j1sebasM9/Dise-o-proyecto-CubeSat-UD34-2026-2/altium/Analisis_BOM_exhaustivo.xlsx

Sheet: Resumen
Numeral 11 – Costo de componentes de la tarjeta CubeSat_UD34_PCB4 (USD)
Solo componentes. Excluye fabricación de PCB, ensamblaje, transporte e impuestos. No es precio de venta.
Tamaño del lote | Costo de componentes del lote (USD) | Costo de componentes por tarjeta (USD) | De ese costo: parte ESTIMADA/pendiente (USD) | % estimado | Observaciones
10 tarjetas | $712.13 | $71.21 | $53.10 | 7.5% | Sin descuentos de volumen en la mayoría de ICs; sobrecompra por múltiplos (LCSC ×100, Samtec ×8).
100 tarjetas | $5655.03 | $56.55 | $445.00 | 7.9% | Escalones de 100 uds en ICs y conectores; el sensor de imagen sigue dominando el costo.
1000 tarjetas | $49551.94 | $49.55 | $4084.00 | 8.2% | Escalón de 1000 uds (carrete completo en DRV8837 y TXS0108 usa cota); sensor AR0135 sin escalón publicado a 1000.
Datos del gráfico (eje X = número de tarjetas, escala log)
Tarjetas | USD/tarjeta
10 | $71.21
100 | $56.55
1000 | $49.55
Mayores contribuyentes por tarjeta (USD/tarjeta)
Componente | 10 tarjetas | 100 tarjetas | 1000 tarjetas
AR0135 (sensor de imagen) | $23.72 | $21.41 | $21.41
J_ACTUATORS Harwin | $12.15 | $10.59 | $7.54
J1_PC104 Samtec ESQ | $14.94 | $7.63 | $5.51
LSM6DSOX (IMU) | $3.49 | $3.05 | $2.79
DRV8313 (BLDC) | $2.53 | $2.09 | $1.86
Regulador MSOP-8 (ESTIMADO) | $3.00 | $3.00 | $3.00

Sheet: Supuestos
Parámetro | Valor | Fuente / nota
Fecha de consulta | 2026-10-26 | Precios leídos de la versión indexada de cada página el 26-oct-2026; pueden variar al abrir la página en vivo.
EUR→USD | 1.12 | https://moneyexchangerate.org/currencyexchange/eur/usd/6 (1 EUR = 1.12 USD, 20-oct-2026). Solo se usa para AR0135 (precio en EUR).
AR0135 EUR @10 | 21.18 | Digi-Key España (Marketplace) https://www.digikey.es/en/products/detail/onsemi/AR0135CS2C00SUEA0-DRBR/7221084
AR0135 EUR @100 | 19.1172 | Misma página. La tabla visible llega solo a 100 uds.
AR0135 EUR @1000 | 19.1172 | ESTIMADO: no hay escalón publicado para 1000; se mantiene el de 100 (cota superior, sin descuento adicional).
Moneda del análisis | USD | Todos los precios en USD salvo AR0135 (EUR convertido con la tasa anterior).
Configuración | Todas las 27 líneas del BOM montadas (86 componentes/tarjeta) | El archivo CubeSat_UD34_PCB4.xlsx no trae columna DNP/variantes: no hay componentes opcionales ni no montados identificables. Misma configuración y mismo criterio de compra en los 3 lotes.
Criterio de compra | Menor precio verificable en distribuidor identificable; precio según la cantidad TOTAL de piezas del lote; se respetan MOQ y múltiplos de empaque (LCSC múltiplos de 100; Samtec tubos de 8); carretes solo si la cantidad necesaria coincide con el carrete. | Sobrantes declarados en cada línea.
Excluido | Fabricación de PCB, ensamblaje, transporte, impuestos/aranceles | Según el numeral 11 de la guía.

Sheet: BOM_Costos
# | Designadores | Descripción (BOM) | Cant./tarjeta | Huella (BOM) | Fabricante | Referencia exacta (MPN) | Origen del MPN | Estado del precio | Proveedor de referencia | Moneda | 10: cant. necesaria | 10: cant. a comprar | 10: precio unit. (USD) | 10: costo (USD) | 10: sobrante | 100: cant. necesaria | 100: cant. a comprar | 100: precio unit. (USD) | 100: costo (USD) | 100: sobrante | 1000: cant. necesaria | 1000: cant. a comprar | 1000: precio unit. (USD) | 1000: costo (USD) | 1000: sobrante | Disponibilidad / plazo | Fuente (URL verificable) | Notas
1 | C1_VBAT, C_3V3, C_3V3_FILT, C_a, C_b, C_IMU_VDD, C_IMU_VDDIO, C_IN2, C_MAG_VDDIO, C_VBAT_FILT, C_VCC_X/Y/Z, C_VCCA, C_VCCB, C_VCP, C_VM1, C_VM2, C_VM_X/Y/Z | Chip Capacitor 100 nF ±10% 50 V 0603 | 21 | CAPC1608X90X40NL10T20 | Samsung Electro-Mechanics | CL10B104KB8NNNC | Propuesto | COTIZADO | LCSC (C1591) | USD | 210 | 300 | $0.0142 | $4.26 | 90 | 2100 | 2100 | $0.0120 | $25.20 | 0 | 21000 | 21000 | $0.0110 | $231.00 | 0 | En stock (≈13.6 M uds); MOQ 100, múltiplo 100; carrete 4000 | https://www.lcsc.com/product-detail/C1591.html | Escalones LCSC: 100+ $0.0142, 1000+ $0.012, 4000+ $0.011. Lote 10: necesita 210 → se compran 300 (múltiplo de 100).
2 | C_1, C_3V3_BULK, C_MAG_CAP, C_VAA_BULK, C_VDD_BULK, C_VDDIO_BULK | Chip Capacitor 10 µF ±10% 16 V 0805 | 6 | CAPC2013X135X45NL10T25 | Samsung Electro-Mechanics | CL21A106KOQNNNE | Propuesto | ESTIMADO | Sin cotización directa (referencia: familia MLCC LCSC) | USD | 60 | 60 | $0.0500 | $3.00 | 0 | 600 | 600 | $0.0400 | $24.00 | 0 | 6000 | 6000 | $0.0350 | $210.00 | 0 | Pendiente de verificar |  | Orden de magnitud para MLCC 10 µF 0805 X5R en LCSC/Digi-Key; verificar antes de comprar.
3 | C_CP | Chip Capacitor 10 nF ±20% 50 V 0402 | 1 | CAPC0402(1005)60_L | Samsung Electro-Mechanics | CL05B103KB5NNNC | Propuesto | ESTIMADO | Sin cotización directa (familia MLCC 0402) | USD | 10 | 10 | $0.0100 | $0.10 | 0 | 100 | 100 | $0.0060 | $0.60 | 0 | 1000 | 1000 | $0.0040 | $4.00 | 0 | Pendiente de verificar |  | Estimado por analogía con CL10B104 (0603) cotizado.
4 | C_IN1 | Chip Capacitor 1 µF ±10% 25 V 0805 | 1 | CAPC2013X145X50ML20T25 | Murata | GRM21BR61E105KA99L | Propuesto | ESTIMADO | Sin cotización directa | USD | 10 | 10 | $0.0300 | $0.30 | 0 | 100 | 100 | $0.0200 | $2.00 | 0 | 1000 | 1000 | $0.0150 | $15.00 | 0 | Pendiente de verificar |  | Estimado; MLCC 1 µF 0805 típico.
5 | C_OUT1 | Tantalio SMD TANTAMOUNT 10 µF ±10% 16 V 1206 (caja A) | 1 | VISH-TR3-A_V | Vishay Semiconductor | TR3A106K016C1700 | Propuesto | ESTIMADO | RS UK / Element14 (familia TR3A, GBP/SGD) | USD | 10 | 10 | $0.7000 | $7.00 | 0 | 100 | 100 | $0.3500 | $35.00 | 0 | 1000 | 1000 | $0.2500 | $250.00 | 0 | Existencia limitada en RS UK | https://uk.rs-online.com/web/p/tantalum-capacitors/6845014 | Estimado a partir de escalones RS UK (£0.233 @250+, £0.171 @1000+) con 1 GBP≈1.30 USD (SUPUESTO). Verificar.
6 | C_p_d | Chip Capacitor 1 µF ±10% 16 V 0603 | 1 | CAPC1608X90X35ML15T15 | Samsung Electro-Mechanics | CL10B105KO8NNNC | Propuesto | ESTIMADO | Sin cotización directa | USD | 10 | 10 | $0.0120 | $0.12 | 0 | 100 | 100 | $0.0090 | $0.90 | 0 | 1000 | 1000 | $0.0070 | $7.00 | 0 | Pendiente de verificar |  | Estimado por analogía con CL10B104 cotizado.
7 | C_V3P3 | Chip Capacitor 470 nF ±20% 25 V 0603 | 1 | CAPC0603(1608)100_L | Samsung Electro-Mechanics | CL10B474KA8NNNC | Propuesto | ESTIMADO | Sin cotización directa | USD | 10 | 10 | $0.0120 | $0.12 | 0 | 100 | 100 | $0.0090 | $0.90 | 0 | 1000 | 1000 | $0.0070 | $7.00 | 0 | Pendiente de verificar |  | Estimado por analogía.
8 | C_VAA1/2, C_VAAPIX1/2, C_VDD1-5, C_VDDIO1-5 | Chip Capacitor 100 nF ±20% 10 V 0402 | 14 | CAPC0402(1005)60_L | Samsung Electro-Mechanics | CL05B104KP5NNNC | Propuesto | ESTIMADO | Sin cotización directa | USD | 140 | 140 | $0.0060 | $0.84 | 0 | 1400 | 1400 | $0.0040 | $5.60 | 0 | 14000 | 14000 | $0.0030 | $42.00 | 0 | Pendiente de verificar |  | Estimado; MLCC 0402 100 nF.
9 | C_VBAT, C_VBAT_BULK | Tantalio 47 µF ±10% 16 V 2917 (7343) | 2 | FP-TPSD-MFG | KEMET | T491D476K016AT | Propuesto | COTIZADO | LCSC (C122248) | USD | 20 | 20 | $0.6806 | $13.61 | 0 | 200 | 200 | $0.5948 | $118.96 | 0 | 2000 | 2000 | $0.4910 | $982.00 | 0 | Stock bajo en LCSC (73 uds en una captura); Digi-Key plazo 13–19 sem | https://www.lcsc.com/product-detail/C122248.html | Descripción del BOM coincide literalmente con 'CAP TANT 47UF 10% 16V 2917' (Digi-Key T491D476K016AT). Para 20 uds no se ve el escalón 10+ en la captura vigente: se usa el de 30+ (conservador).
10 | C_VM_BULK | Cerámico CL32 100 µF ±20% 10 V X5R 1210 | 1 | CAPC3225X280N | Samsung Electro-Mechanics | CL32A107MPVNNNE | BOM (descripción) | COTIZADO | LCSC (C23742) | USD | 10 | 10 | $0.2519 | $2.52 | 0 | 100 | 100 | $0.1977 | $19.77 | 0 | 1000 | 1000 | $0.1627 | $162.70 | 0 | En stock (≈61 k uds); carrete 1000 | https://www.lcsc.com/product-detail/C23742.html | Escalones LCSC: 10+ $0.2519, 100+ $0.1977, 1000+ $0.1627.
11 | D1_ESD, D1_ESD_B | TVS 5.5 V SOT143B | 2 | FP-SOT143B-MFG | Nexperia | PRTR5V0U2X,215 | BOM | COTIZADO | Digi-Key (vía agregador Ciiva) | USD | 20 | 20 | $0.4100 | $8.20 | 0 | 200 | 200 | $0.2626 | $52.52 | 0 | 2000 | 2000 | $0.1786 | $357.20 | 0 | RIESGO: stock 0 en Digi-Key; Farnell JP lo marca 'No Longer Manufactured'; LCSC agotado | https://ciiva.com/part/prtr5v0u2x-215-26504288 | Escalones tomados de la fila Digi-Key (1: $0.66, 10: $0.41, 100: $0.2626, 1000: $0.1786). Hay precios muy dispares en otros sitios ($0.11–$2.2): verificar obsolescencia/alternativa (PRTR5V0U2AX/-F).
12 | FL | Ferrita/bead 0603 (sin descripción en BOM) | 1 | BEADC1608X95N | (vacío en BOM) | Sin MPN en BOM — propuesto: Murata BLM18PG221SN1D | Propuesto | ESTIMADO | Sin cotización | USD | 10 | 10 | $0.1000 | $1.00 | 0 | 100 | 100 | $0.0600 | $6.00 | 0 | 1000 | 1000 | $0.0400 | $40.00 | 0 | Pendiente |  | ESTIMADO: el BOM no define valor (impedancia/corriente). Precio típico de bead 0603 de potencia.
13 | J1_PC104 | Conector PC/104 hembra 52 pos, 2×26, 2.54 mm | 1 | SAMTEC_ESQ-126-12-G-D | Samtec | ESQ-126-12-G-D | BOM (huella) | COTIZADO | Samtec directo / Digi-Key (SAM11112-ND) | USD | 10 | 16 | $9.3400 | $149.44 | 6 | 100 | 104 | $7.3320 | $762.53 | 4 | 1000 | 1000 | $5.5080 | $5508.00 | 0 | En stock (32 uds 'ships tomorrow' + 151 distribuidor); empaque tubo de 8 | https://www.samtec.com/products/esq-126-12-g-d | Escalones Samtec: 1 $10.43, 10 $9.34, 100 $7.332, 1000 $5.508. Se compran múltiplos de 8 (tubo): lote 10 → 16 uds; lote 100 → 104 uds.
14 | J_ACTUATORS | Conector Harwin Gecko 1.25 mm, 2×6, hembra vertical | 1 | HARWIN_G125-FV11205L0P | Harwin | G125-FV11205L0P | BOM (huella) | COTIZADO | Mouser (855-G125-FV11205L0P), vía espejo the-esb.com | USD | 10 | 10 | $12.1500 | $121.50 | 0 | 100 | 100 | $10.5900 | $1059.00 | 0 | 1000 | 1000 | $7.5400 | $7540.00 | 0 | Mouser: 105 uds; TTI en pedido (plazo 13 sem) | https://the-esb.com/part/g125fv11205l0p~harwin | Mouser: 1 $13.71, 10 $12.15, 100 $10.59, 1K $7.54. TTI: 100 $9.28, 1K $7.48 (https://thepartsdirect.com/part/g125fv11205l0p~harwin). Lote 10 es el segundo ítem más caro.
15 | R1-R5, R_a, R_CAM_RST, R_IMU_CS, R_MAG_SCL, R_MAG_SDA, R_OE_PULLDOWN, R_PULL_EN, R_SLEEP_X/Y/Z, Regf | Resistor 10 kΩ ±1% 0.1 W 0603 | 16 | RESC1608X55X25ML10T15 | Yageo | RC0603FR-0710KL | Propuesto | ESTIMADO | LCSC C98220 / RS (referencias) | USD | 160 | 160 | $0.0060 | $0.96 | 0 | 1600 | 1600 | $0.0040 | $6.40 | 0 | 16000 | 16000 | $0.0020 | $32.00 | 0 | En stock (≈9 M en LCSC) | https://www.lcsc.com/product-image/C98220.html | LCSC lista precio desde $0.0008 a cantidad de carrete; RS UK £0.004–0.006 por RC0603FR-07xxx. Se usa un precio de pequeña cantidad (estimado).
16 | R_COMP_2 | Resistor 1 kΩ ±1% 0.1 W 0603 | 1 | RESC1608X55X25ML10T15 | Yageo | RC0603FR-071KL | Propuesto | ESTIMADO | Referencia RS/LCSC | USD | 10 | 10 | $0.0060 | $0.06 | 0 | 100 | 100 | $0.0040 | $0.40 | 0 | 1000 | 1000 | $0.0020 | $2.00 | 0 | En stock |  | Igual criterio que 10 kΩ.
17 | R_I2C_SCL, R_I2C_SDA | Resistor 1.5 kΩ ±0.1% 1/10 W 0603 (película delgada) | 2 | RES_ERA3ARB152V | Panasonic | ERA3ARB152V (BOM) → sucesor ERA-3AEB152V | BOM (huella) | ESTIMADO | Master Electronics / RS / derf (referencias) | USD | 20 | 20 | $0.1080 | $2.16 | 0 | 200 | 200 | $0.0600 | $12.00 | 0 | 2000 | 2000 | $0.0500 | $100.00 | 0 | ERA3ARB152V DESCONTINUADO en RS; ERA-3AEB152V: MOQ 5000 en Master (plazo 12 sem) | https://masterelectronics.com/en/panasonic/era3aeb152v-44450459.html | Master: 5000 @ $0.0287 (MOQ 5000). derf.com (ERA-3YEB152V): $0.108 @11–50. RS UK: £0.022 @500+. Los lotes 100/1000 son estimados entre esas referencias. Descontinuado: https://uk.rs-online.com/p/surface-mount-resistors/6618691
18 | R_SENSE | Shunt 100 mΩ ±1% 1 W 1206 AEC-Q200 metal | 1 | RESC3216X89N | Vishay | WSLP1206R1000FEA | Propuesto | ESTIMADO | Farnell (familia WSLP1206, proxy USD) | USD | 10 | 10 | $0.7380 | $7.38 | 0 | 100 | 100 | $0.5080 | $50.80 | 0 | 1000 | 1000 | $0.3730 | $373.00 | 0 | Familia en stock; verificar este valor | https://il.farnell.com/vishay/wslp12061l000fea/current-sense-res-0r001-1-1-w/dp/2420760 | PROXY: no se obtuvo la página del valor 100 mΩ; se usan los escalones del WSLP12061L000FEA (mismo tamaño/serie, 10+ $0.738, 100+ $0.508, 1000+ $0.373).
19 | Reg_ | Resistor 130 kΩ ±1% 0.1 W 0603 | 1 | RESC1608X55N | Yageo | RC0603FR-07130KL | Propuesto | ESTIMADO | Referencia RS/LCSC | USD | 10 | 10 | $0.0060 | $0.06 | 0 | 100 | 100 | $0.0040 | $0.40 | 0 | 1000 | 1000 | $0.0020 | $2.00 | 0 | En stock |  | Igual criterio que 10 kΩ.
20 | Regulador | Regulador/IC MSOP-8 (sin descripción, sin MPN en BOM) | 1 | MSOP-8_MS | (vacío en BOM) | SIN IDENTIFICAR — pendiente | Propuesto | ESTIMADO | Sin cotización | USD | 10 | 10 | $3.0000 | $30.00 | 0 | 100 | 100 | $3.0000 | $300.00 | 0 | 1000 | 1000 | $3.0000 | $3000.00 | 0 | Pendiente |  | PENDIENTE: el BOM no identifica el IC. Marcador de $3.00 (rango típico MSOP-8 regulador/PMIC $1.5–$5), sin descuento por volumen. Es la mayor incertidumbre del cálculo.
21 | U1_CAM_PWR | Load switch 5.5 V, 1.5 A, 90 mΩ con descarga ajustable | 1 | SOT65P210X110-6N | Texas Instruments | TPS22919DCKR | Propuesto | COTIZADO | Digi-Key US (296-TPS22919DCKRCT-ND) | USD | 10 | 10 | $0.1330 | $1.33 | 0 | 100 | 100 | $0.1000 | $10.00 | 0 | 1000 | 1000 | $0.0826 | $82.61 | 0 | En stock (≈144 k uds); plazo 6 sem | https://www.digikey.com/en/products/detail/texas-instruments/TPS22919DCKR/10434801 | Identificado por la descripción exacta del BOM (TI TPS22919, SC70-6). DK: 1 $0.20, 10 $0.133, 100 $0.10, 1000 $0.08261.
22 | U1_IMU | IMU iNEMO 3D acel.+giro | 1 | FP-LGA-14L-DM00249496-MFG | STMicroelectronics | LSM6DSOXTR | BOM | COTIZADO | Digi-Key US (497-18367-1-ND) | USD | 10 | 10 | $3.4870 | $34.87 | 0 | 100 | 100 | $3.0519 | $305.19 | 0 | 1000 | 1000 | $2.7870 | $2787.05 | 0 | En stock en capturas previas (19–28 k); plazo 20–24 sem | https://www.digikey.com/en/products/detail/stmicroelectronics/LSM6DSOXTR/9841887 | DK: 1 $4.07, 10 $3.487, 100 $3.0519, 500 $2.81442, 1000 $2.78705. OJO: otras capturas/regiones muestran $3.51 (@1) a $7.36 (@1): precio volátil.
23 | U1_MTQ_X, U2_MTQ_Y, U3_MTQ_Z | Driver puente H 12 V, 1 A | 3 | SON50P200X200X80-9N | Texas Instruments | DRV8837CDSGR | BOM | COTIZADO | Digi-Key US (296-47205-1-ND) | USD | 30 | 30 | $0.4944 | $14.83 | 0 | 300 | 300 | $0.4041 | $121.24 | 0 | 3000 | 3000 | $0.3543 | $1062.90 | 0 | En stock (≈72 k uds) | https://www.digikey.com/en/products/detail/texas-instruments/DRV8837CDSGR/7688215 | DK: 25 $0.4944, 250 $0.40412, 1000 $0.37214, carrete 3000 $0.3543. Lote 1000 = 3000 uds = 1 carrete completo (sin sobrante).
24 | U2 | Sensor de imagen CMOS 1.2 MP (color), iBGA-63 | 1 | BGA63C100P8X8_900X900X144N | onsemi | AR0135CS2C00SUEA0-DRBR | BOM | COTIZADO | Digi-Key España — Marketplace (5556-AR0135CS2C00SUEA0-DRBR-ND) | USD | 10 | 10 | $23.7216 | $237.22 | 0 | 100 | 100 | $21.4113 | $2141.13 | 0 | 1000 | 1000 | $21.4113 | $21411.26 | 0 | Stock fábrica 2,600; plazo 20 sem; ítem Marketplace (vendedor externo) | https://www.digikey.es/en/products/detail/onsemi/AR0135CS2C00SUEA0-DRBR/7221084 | DK ES (EUR): 1 €23.93, 10 €21.18, 100 €19.1172. Sin escalón a 1000 → se mantiene €19.1172 (cota superior). Es el componente dominante del costo. Hay listados 'obsoletos' en otros sitios para variantes -DPBR/-DRBR1: confirmar ciclo de vida.
25 | U2_MAG | Magnetómetro 3 ejes MMC5983MA (IC) | 1 | PQFN50P300X300X100-16N | MEMSIC | MMC5983MA | BOM | COTIZADO | Digi-Key US (1267-MMC5983MACT-ND) | USD | 10 | 10 | $2.3780 | $23.78 | 0 | 100 | 100 | $2.0681 | $206.81 | 0 | 1000 | 1000 | $1.8360 | $1836.04 | 0 | En stock (≈29–68 k uds); plazo 8 sem | https://www.digikey.com/en/products/detail/memsic-inc/MMC5983MA/10452795 | La descripción del BOM dice 'Evaluation Board' (MMC5983MA-B, $20.95) pero el MPN es el IC: se cotiza el IC. Corregir descripción del BOM.
26 | U3_LEVEL_SHIFTER, U4_LEVEL_SHIFTER | Traductor de nivel bidireccional 20-TSSOP (PW0020A) | 2 | FP-PW0020A-IPC_A | Texas Instruments | TXS0108EPWR | Propuesto | COTIZADO | Digi-Key US (296-23011-1-ND) | USD | 20 | 20 | $1.1080 | $22.16 | 0 | 200 | 200 | $0.8928 | $178.56 | 0 | 2000 | 2000 | $0.8231 | $1646.28 | 0 | En stock (≈17 k uds) | https://www.digikey.com/en/products/detail/texas-instruments/TXS0108EPWR/1775302 | DK US: 10 $1.108, 100 $0.8928, 500 $0.82314. A 2000 uds no se ve el escalón de carrete en la captura: se usa el de 500 (cota superior). MPN propuesto: el BOM solo dice '8-bit bidireccional 20-TSSOP'.
27 | U4_BLDC | Driver BLDC 3 fases 8–60 V, 28-HTSSOP | 1 | FP-PWP0028C-IPC_A | Texas Instruments | DRV8313PWPR | Propuesto | COTIZADO | Digi-Key (USD, sitio .com.mx) | USD | 10 | 10 | $2.5310 | $25.31 | 0 | 100 | 100 | $2.0913 | $209.13 | 0 | 1000 | 1000 | $1.8609 | $1860.90 | 0 | En stock en capturas (≈2 k–5.7 k, otros 0); plazo 18 sem | https://www.digikey.com/en/products/detail/texas-instruments/DRV8313PWPR/3775439 | Precios USD leídos de la página digikey.com.mx (10 $2.531, 100 $2.0913, 1000 $1.8609, carrete 2000 $1.8161). Otros agregadores muestran $4.0–4.1 @1 (Mouser/TI). Verificar en vivo.
TOTAL |  |  | 86 |  |  |  |  |  |  |  |  |  |  | $712.13 |  |  |  |  | $5655.03 |  |  |  |  | $49551.94

Sheet: Fuentes
Componente | Proveedor | URL | Qué verificar
AR0135CS2C00SUEA0-DRBR | Digi-Key España (Marketplace) | https://www.digikey.es/en/products/detail/onsemi/AR0135CS2C00SUEA0-DRBR/7221084 | Tabla Tray EUR: 1/5/10/25/50/100
LSM6DSOXTR | Digi-Key US | https://www.digikey.com/en/products/detail/stmicroelectronics/LSM6DSOXTR/9841887 | Cut Tape USD
MMC5983MA | Digi-Key US | https://www.digikey.com/en/products/detail/memsic-inc/MMC5983MA/10452795 | Cut Tape USD
DRV8837CDSGR | Digi-Key US | https://www.digikey.com/en/products/detail/texas-instruments/DRV8837CDSGR/7688215 | Cut Tape y Tape&Reel USD
DRV8313PWPR | Digi-Key (.com.mx en USD) | https://www.digikey.com/en/products/detail/texas-instruments/DRV8313PWPR/3775439 | Cambiar país a México/USD si el sitio US muestra otra cosa
TPS22919DCKR | Digi-Key US | https://www.digikey.com/en/products/detail/texas-instruments/TPS22919DCKR/10434801 | Cut Tape USD
TXS0108EPWR | Digi-Key US | https://www.digikey.com/en/products/detail/texas-instruments/TXS0108EPWR/1775302 | Cut Tape USD
ESQ-126-12-G-D | Samtec / Digi-Key | https://www.samtec.com/products/esq-126-12-g-d | Breaks 1/10/25/50/100/500/1000/2000; Mult 8
ESQ-126-12-G-D | Digi-Key | https://www.digikey.com/en/products/detail/samtec-inc/ESQ-126-12-G-D/6694915 | Empaque estándar 8, $10.43 @1
G125-FV11205L0P | Mouser (espejo the-esb.com) | https://the-esb.com/part/g125fv11205l0p~harwin | Mouser 855-G125-FV11205L0P
G125-FV11205L0P | TTI (espejo thepartsdirect) | https://thepartsdirect.com/part/g125fv11205l0p~harwin | 100 $9.28, 1K $7.48
PRTR5V0U2X,215 | Digi-Key vía Ciiva | https://ciiva.com/part/prtr5v0u2x-215-26504288 | Fila DigiKey; stock 0
PRTR5V0U2X,215 | Farnell JP (estado) | https://jp.farnell.com/en-JP/nexperia/prtr5v0u2x-215/diode-tvs-dual-sot-143b/dp/1524157 | 'No Longer Manufactured'
CL10B104KB8NNNC | LCSC C1591 | https://www.lcsc.com/product-detail/C1591.html | 100+/1000+/4000+
CL32A107MPVNNNE | LCSC C23742 | https://www.lcsc.com/product-detail/C23742.html | 1+/10+/30+/100+/500+/1000+
T491D476K016AT | LCSC C122248 | https://www.lcsc.com/product-detail/C122248.html | 30+/100+/500+/1000+
WSLP1206 (proxy) | Farnell IL | https://il.farnell.com/vishay/wslp12061l000fea/current-sense-res-0r001-1-1-w/dp/2420760 | 10+/100+/1000+ (valor 1 mΩ, proxy)
ERA-3AEB152V | Master Electronics | https://masterelectronics.com/en/panasonic/era3aeb152v-44450459.html | MOQ 5000, $0.0287
ERA3ARB152V | RS UK (descontinuado) | https://uk.rs-online.com/p/surface-mount-resistors/6618691 | Estado 'Discontinued'
TR3A106K016C1700 | RS UK | https://uk.rs-online.com/web/p/tantalum-capacitors/6845014 | Escalones en GBP
TPS22919 (identificación) | TI | https://www.ti.com/product/TPS22919 | Descripción coincide con el BOM
EUR→USD | moneyexchangerate.org | https://moneyexchangerate.org/currencyexchange/eur/usd/6 | 1 EUR = 1.12 USD (20-oct-2026)
