j1sebasM9/Dise-o-proyecto-CubeSat-UD34-2026-2/altium/Esquematicos_PDF/Block_Payload.pdf

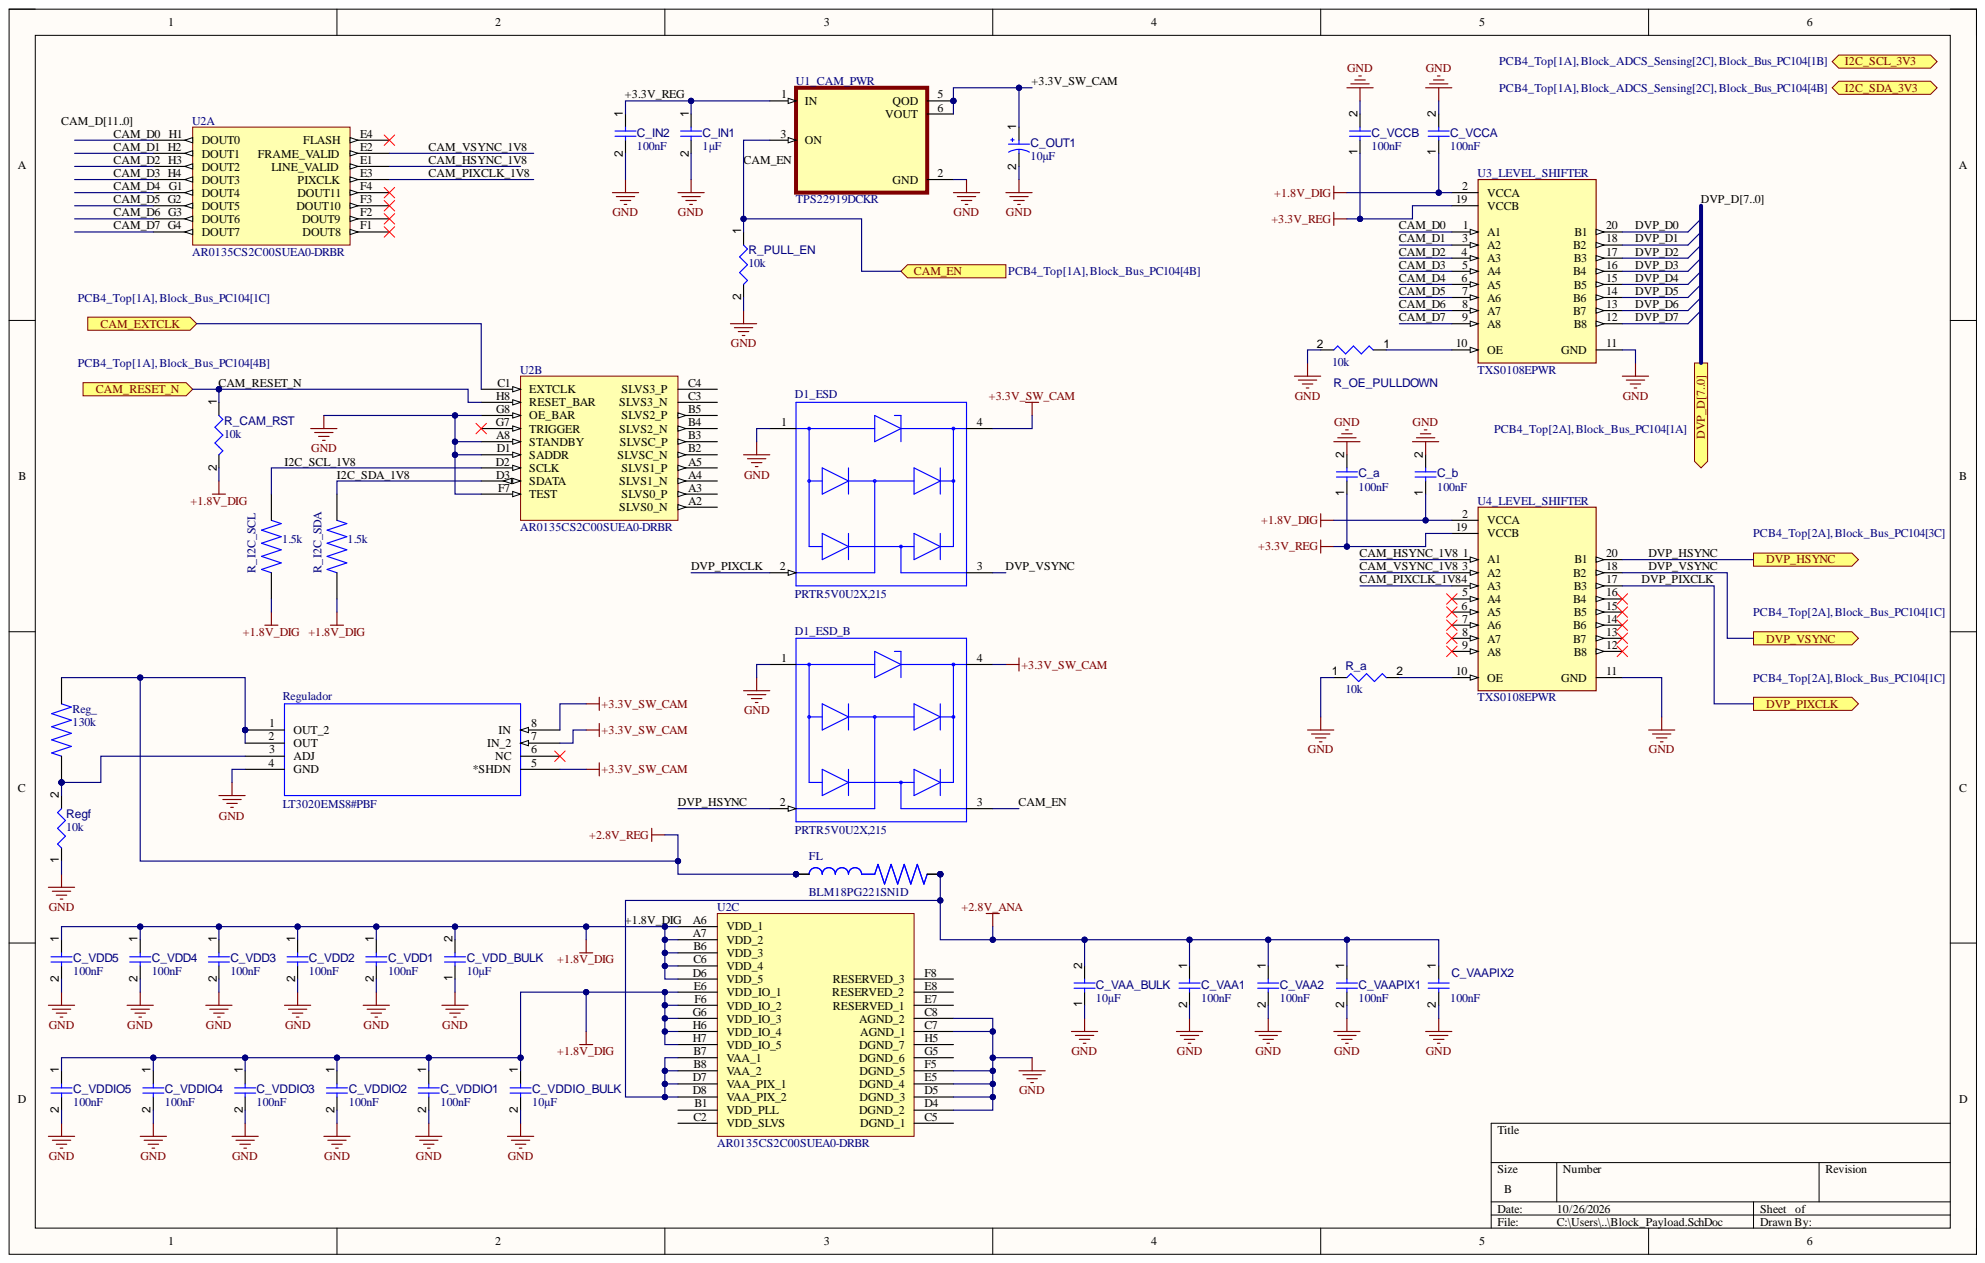
[picture p1: page 1]

TRIGGER G7

SADDR D1
SCLK D2

I2C_SDA_1V8 | SDATA D3

VDD_2 A7
VDD_3 B6

VAA_1 B7
VAA_2 B8
VAA_PIX_1 D7
VAA_PIX_2 D8
