j1sebasM9/Dise-o-proyecto-CubeSat-UD34-2026-2/altium/Esquematicos_PDF/PCB4_Top.pdf

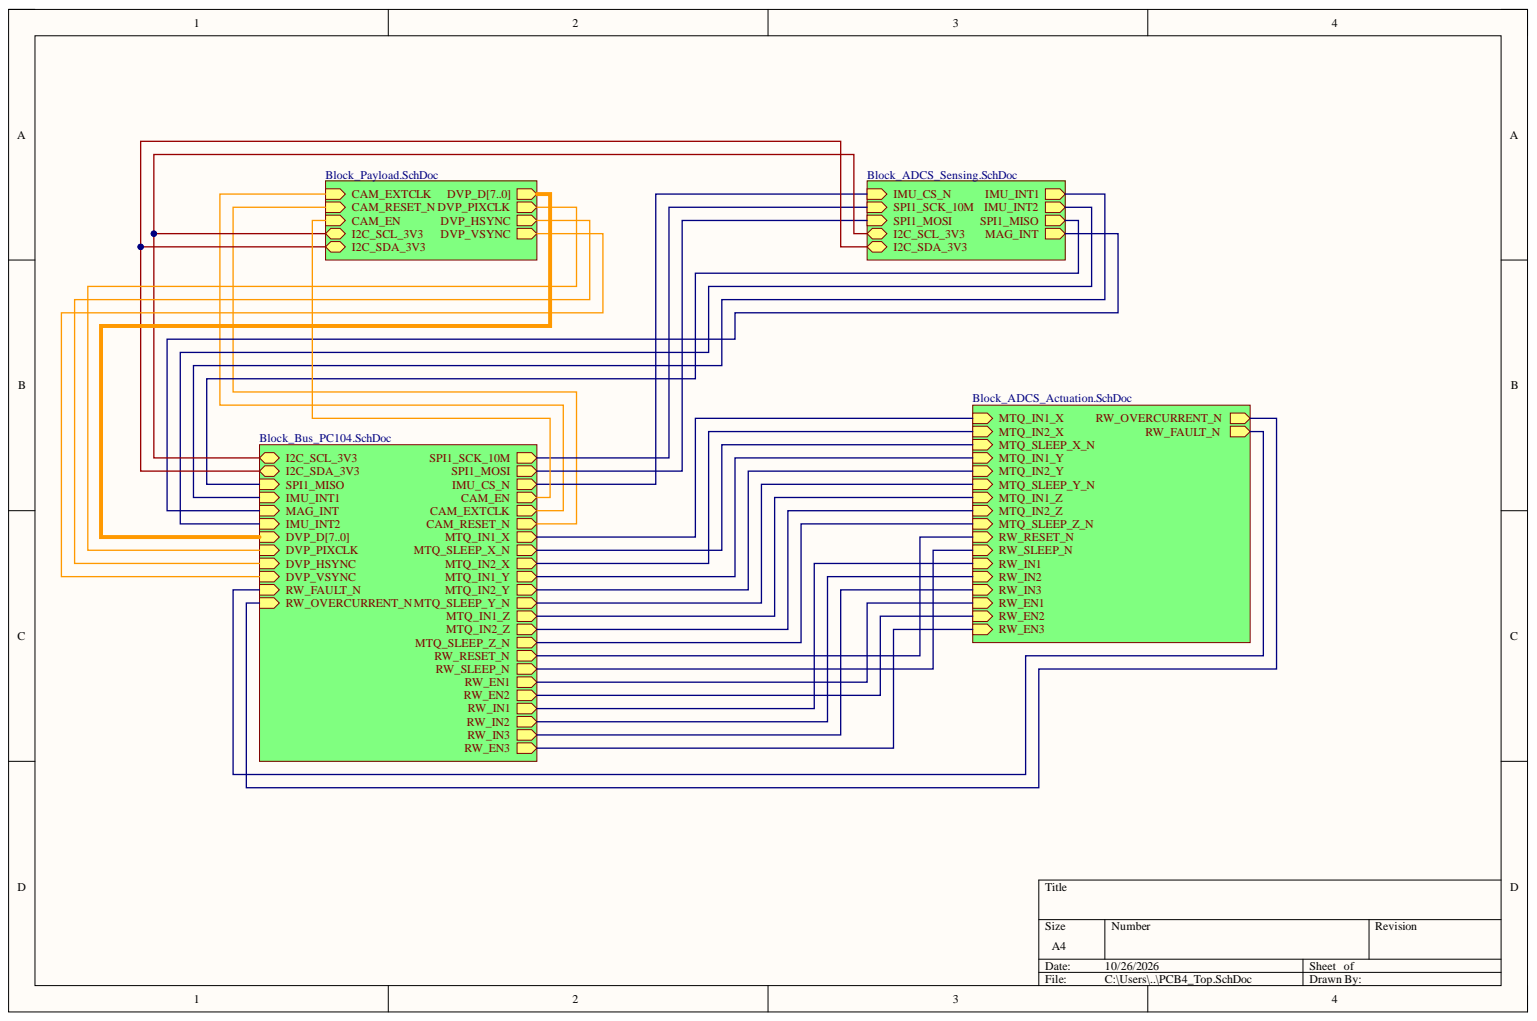
[picture p2: page 1]

I2C_SCL_3V3
I2C_SDA_3V3 SPI1_MISO IMU_INT1 MAG_INT IMU_INT2 DVP_D[7..0] DVP_PIXCLK DVP_HSYNC DVP_VSYNC RW_FAULT_N
IMU_CS_N CAM_EN CAM_EXTCLK CAM_RESET_N MTQ_IN1_X MTQ_SLEEP_X_N MTQ_IN2_X MTQ_IN1_Y MTQ_IN2_Y RW_OVERCURRENT_N MTQ_SLEEP_Y_N MTQ_IN1_Z MTQ_IN2_Z MTQ_SLEEP_Z_N RW_RESET_N RW_SLEEP_N RW_EN1 RW_EN2 RW_IN1 RW_IN2 RW_IN3 RW_EN3
