j1sebasM9/Dise-o-proyecto-CubeSat-UD34-2026-2/altium/Esquematicos_PDF/Block_ADCS_Actuation.pdf

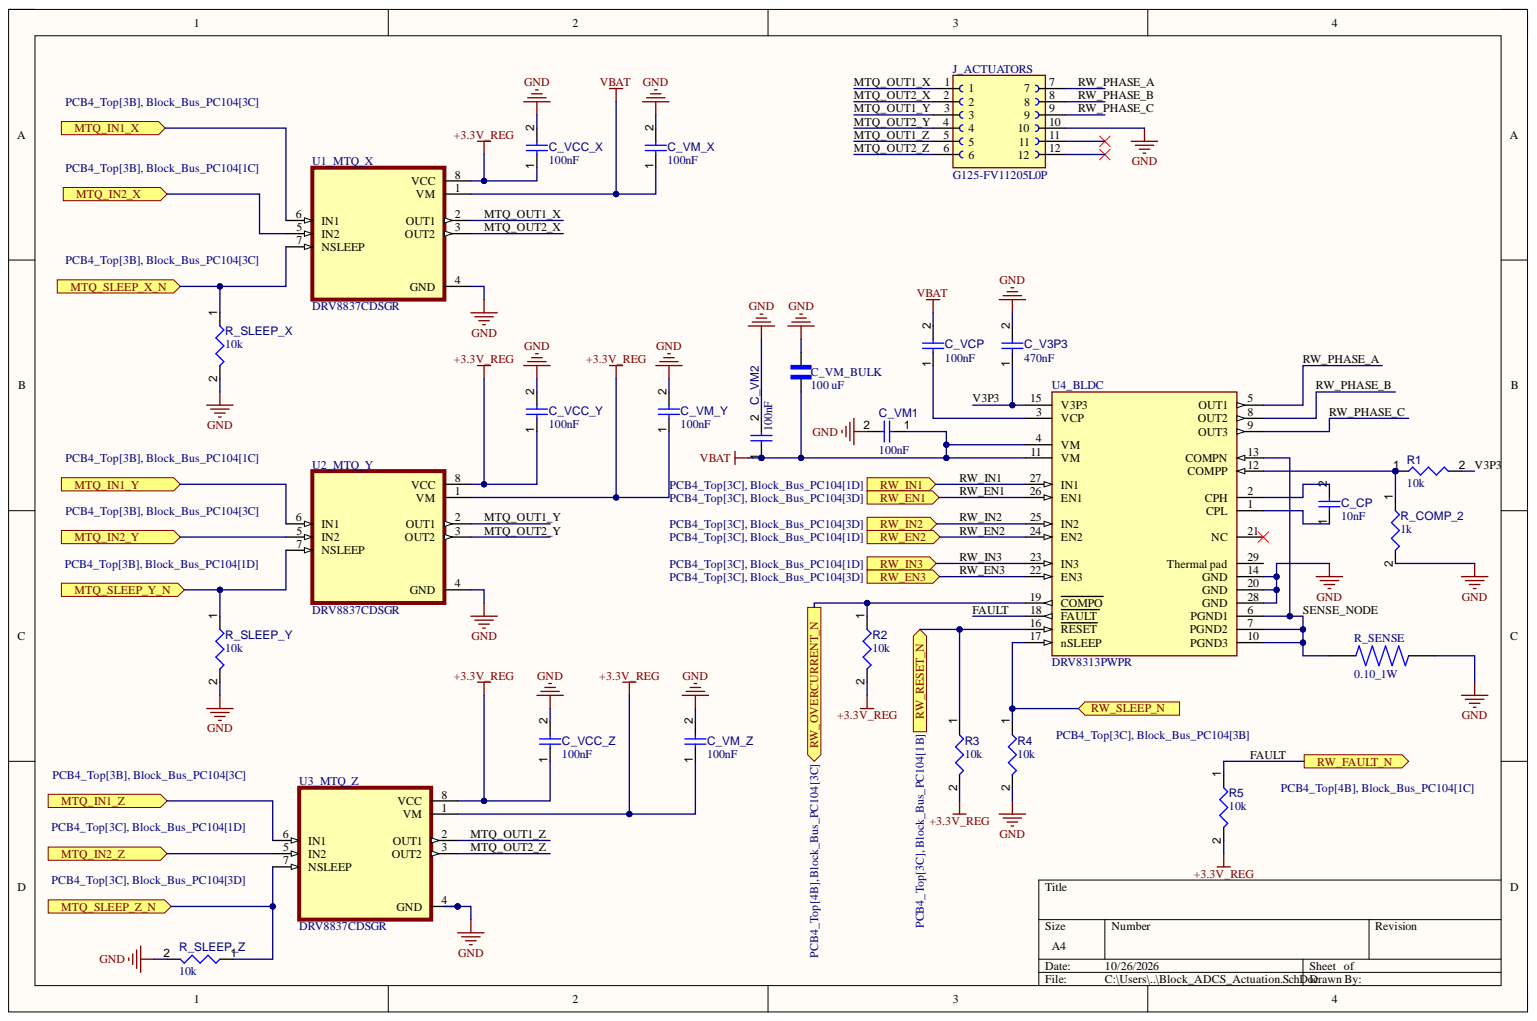
[picture p3: page 1]
