j1sebasM9/Dise-o-proyecto-CubeSat-UD34-2026-2/altium/Esquematicos_PDF/Block_ADCS_Sensing.pdf

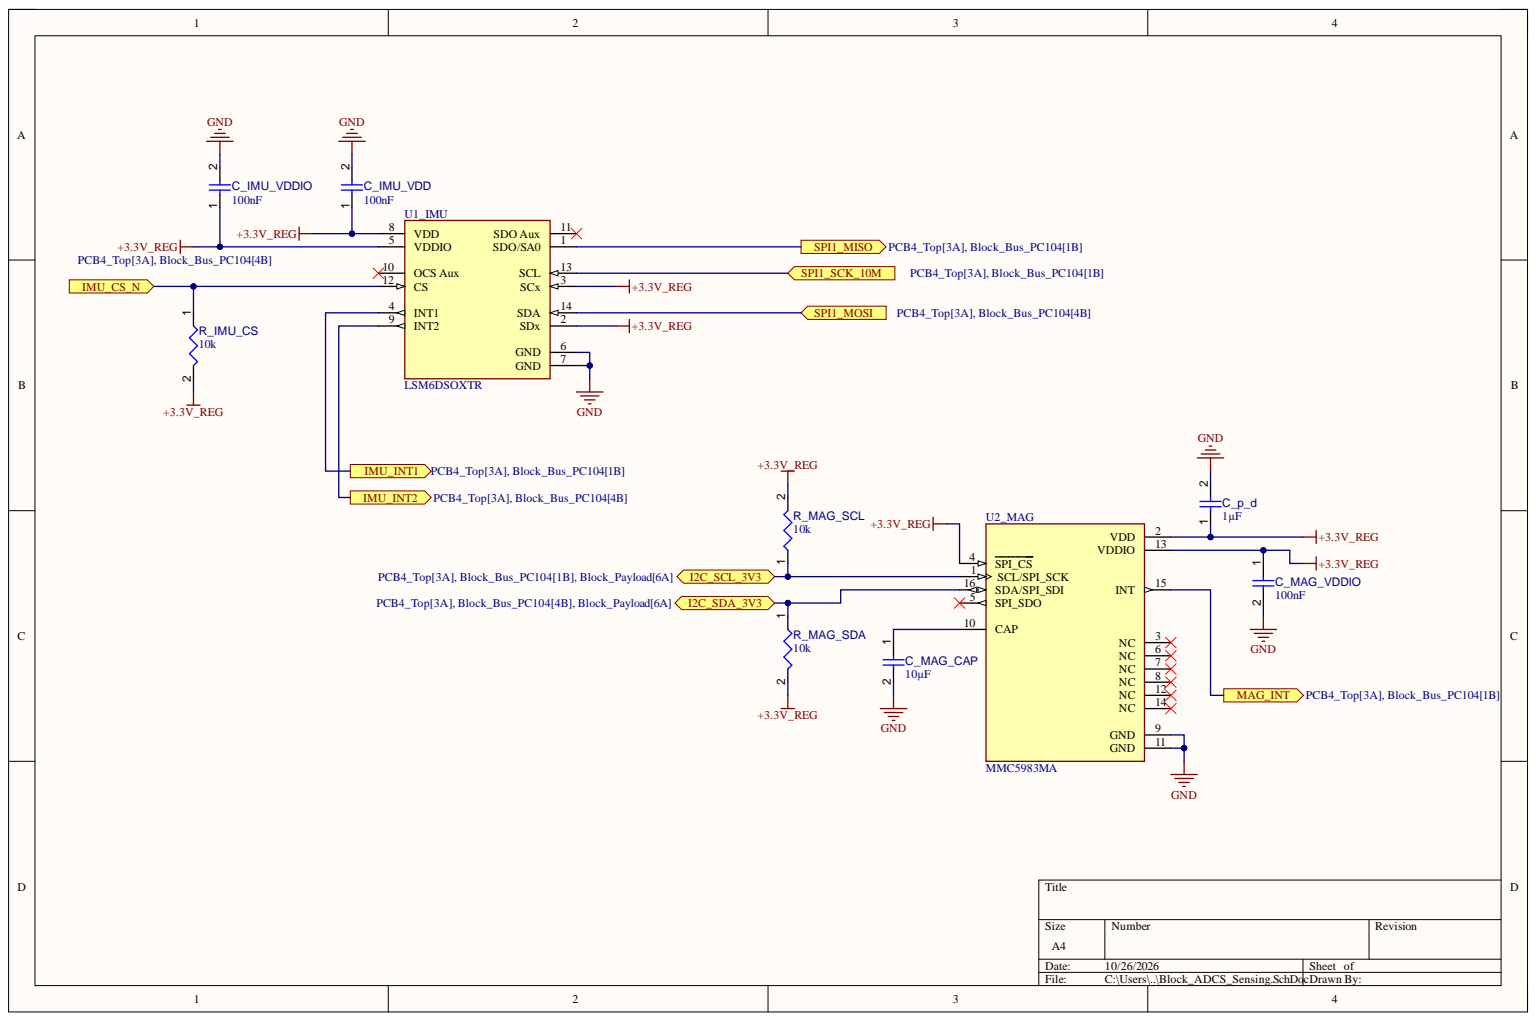
[picture p4: page 1]
