j1sebasM9/Dise-o-proyecto-CubeSat-UD34-2026-2/altium/Esquematicos_PDF/Block_Bus_PC104.pdf

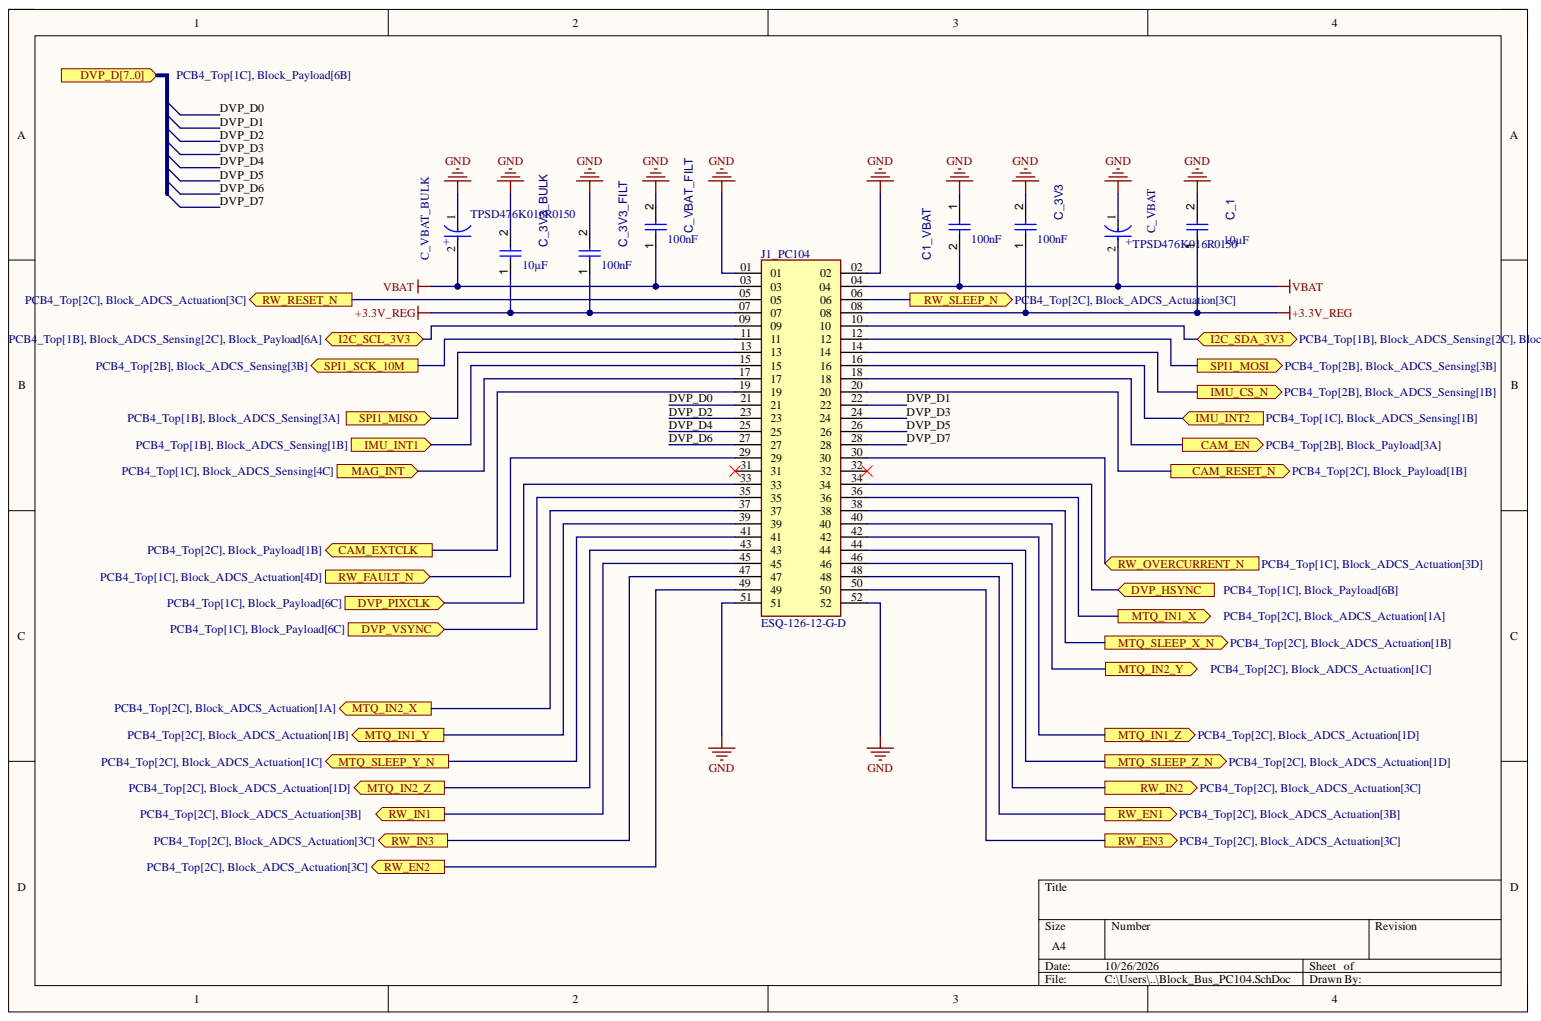
[picture p5: page 1]

09 09
11 11
13 13
15 15
17 17
19 19

DVP_D0 DVP_D2 | 21 21 23 23 | | DVP_D1 DVP_D3

DVP_D4 DVP_D6 | 25 25 27 27 | | DVP_D5 DVP_D7

29 29
31 31
33 33
35 35
37 37
39 39
41 41
43 43
45 45
47 47
49 49
51 51
