j1sebasM9/Dise-o-proyecto-CubeSat-UD34-2026-2/(list of files, drawings)

Other design files:
altium/Block_ADCS_Actuation.SchDoc
altium/Block_ADCS_Sensing.SchDoc
altium/Block_Bus_PC104.SchDoc
altium/Block_Payload.SchDoc
altium/CubeSat_UD34_PCB4.PrjPcb
altium/PCB4_Top.SchDoc
