j1sebasM9/Dise-o-proyecto-CubeSat-UD34-2026-2/(commit log)

2026-10-15 Estructura inicial de carpetas del repositorio
2026-10-15 Diapositivas de clase
2026-10-15 Datashets de diferentes componentes pcb_4
2026-10-15 Datasheets del sensor CMOS ARO135CS image sensor
    Technical Documentation CMOS Image Sensor, Digital, Global Shutter,1.2 MP, 1/3"
2026-10-15 Datasheets sensores y dispositivos
2026-10-27 Proyecto nativo
    Archivo principal del proyecto en altium.
    [CubeSat_UD34_PCB4.PrjPcb]
2026-10-27 Esquematicos del proyecto.
    [Block_ADCS_Actuation.SchDoc, Block_ADCS_Sensing.SchDoc, Block_Bus_PC104.SchDoc, Block_Payload.SchDoc, PCB4_Top.SchDoc]
2026-10-27 Calculos_Matriz_BOM
    Hoja de cálculo editable con la matriz de restricciones, cálculos de componentes y el análisis de costos.
    [Analisis_BOM_exhaustivo.xlsx, CubeSat_UD34_PCB4.xlsx]
2026-10-27 Librería propia editable de esquemáticos
